AhmedHafez2000/Efficiency-Meter/PCB/README.md

# Pritable PCB
It is a file for DIY project and it represents the bottom side of V2 PCB.
The top side connections are jumper wires.
 
NOTE: Make sure to print the file in actual size scale
