AhmedHafez2000/Efficiency-Meter/PCB/2D-Top-V2.png

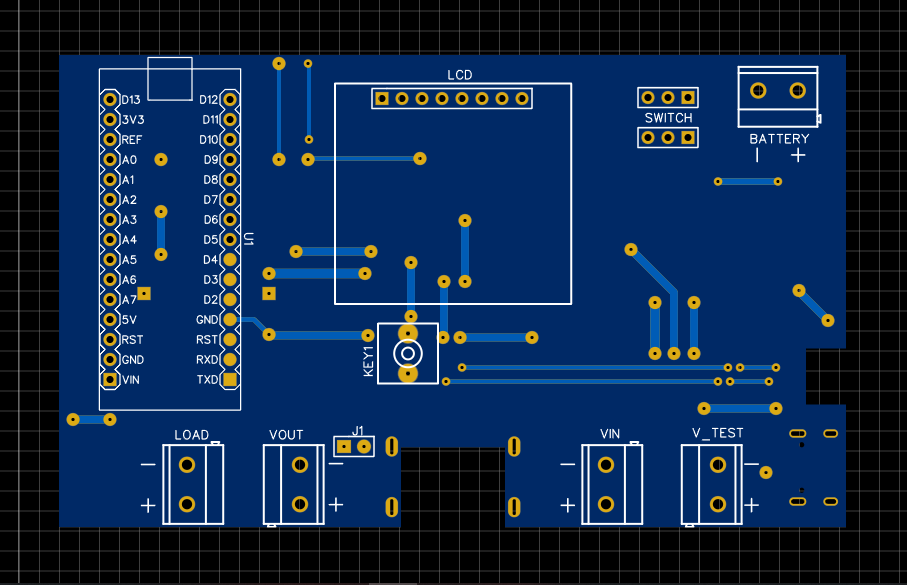
PCB/2D-Top-V2.png
