AhmedHafez2000/Efficiency-Meter/PCB/V3-2D-Top.png

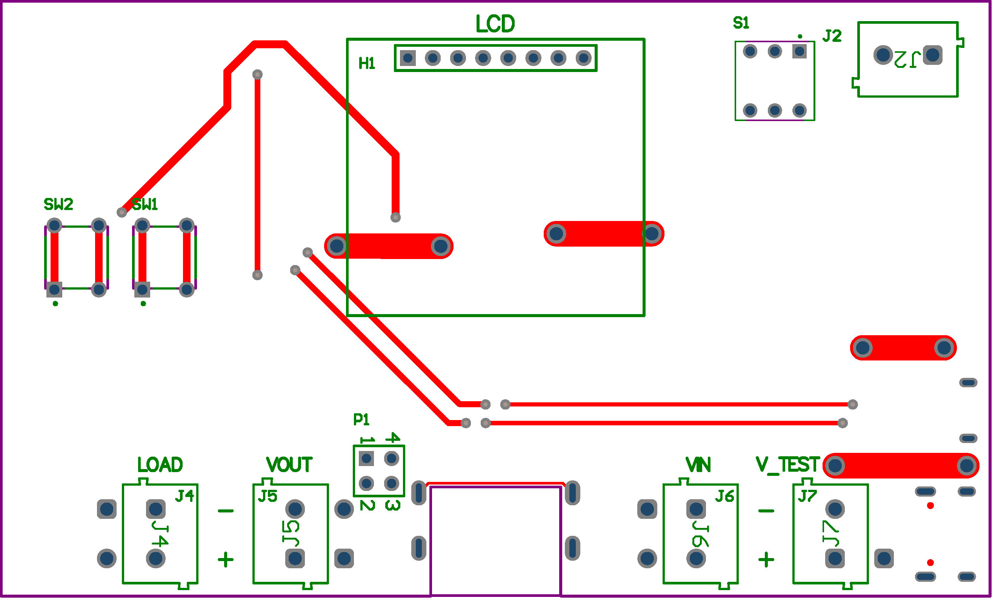
PCB/V3-2D-Top.png
