AhmedHafez2000/Efficiency-Meter/Photos/IMG_1.jpg

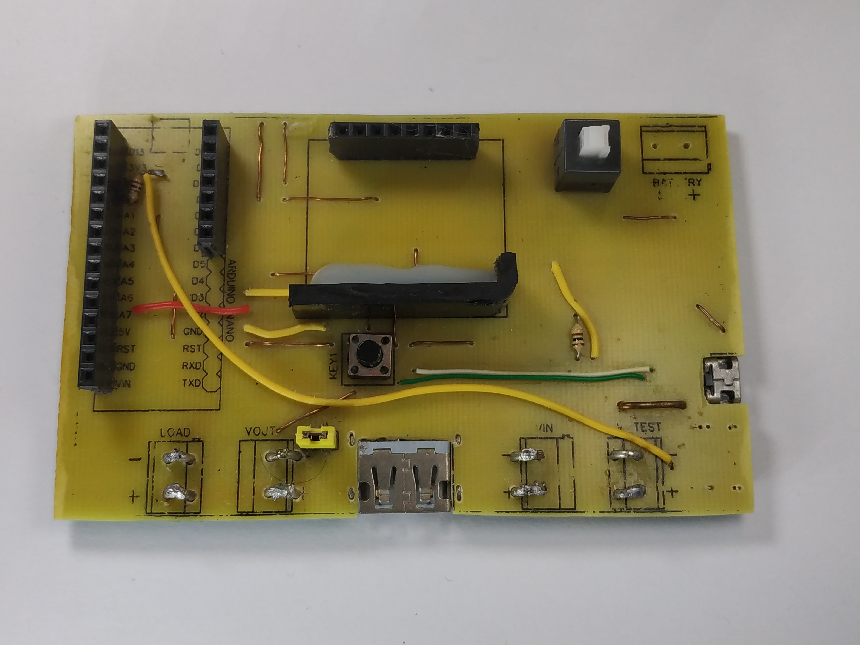
Photos/IMG_1.jpg
