AhmedHafez2000/Efficiency-Meter/Photos/IMG_5.jpg

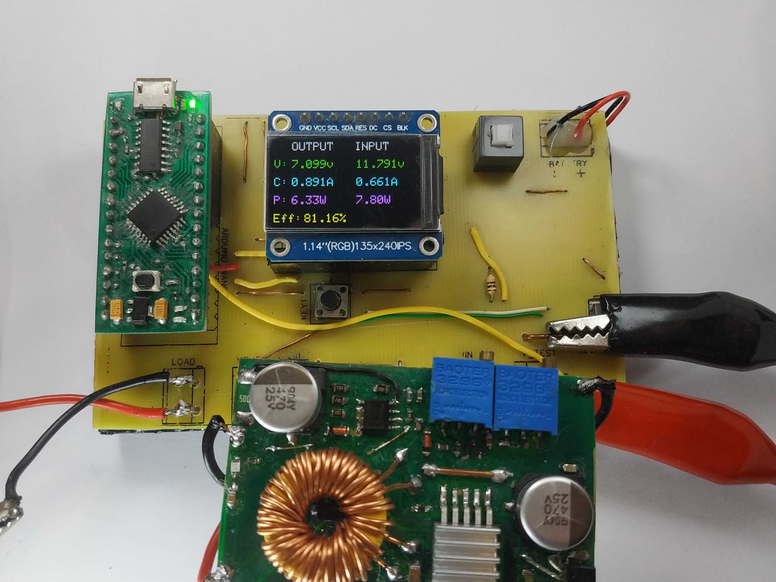
Photos/IMG_5.jpg
