AhmedHafez2000/Efficiency-Meter/Photos/IMG_6.jpg

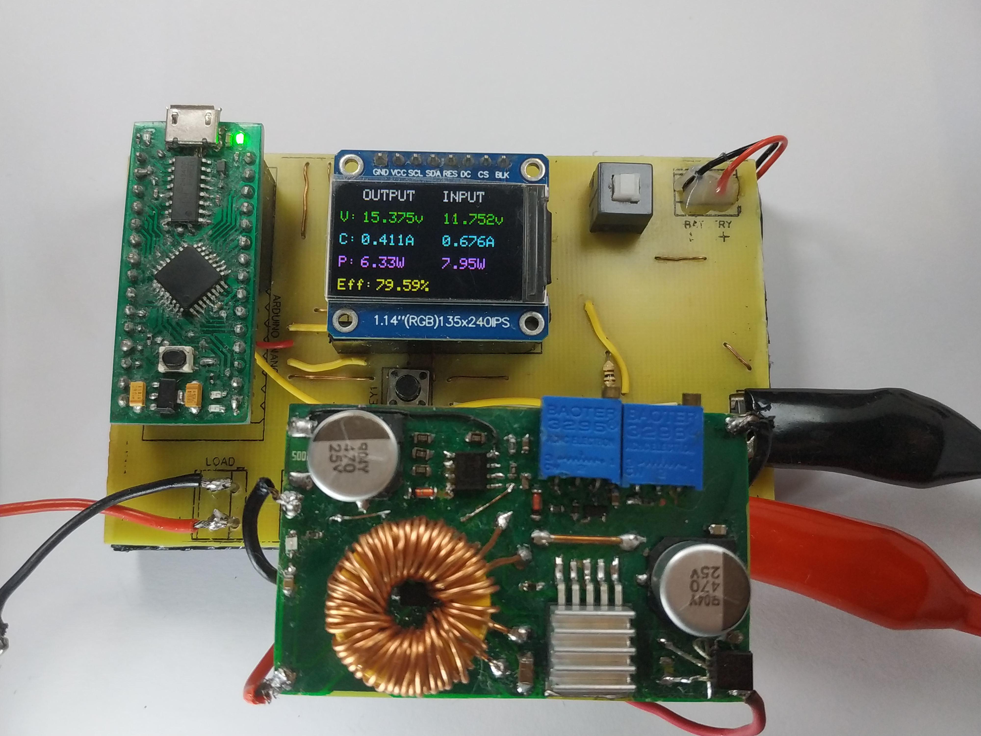
Photos/IMG_6.jpg
