AhmedHafez2000/Efficiency-Meter/Photos/IMG_7.jpg

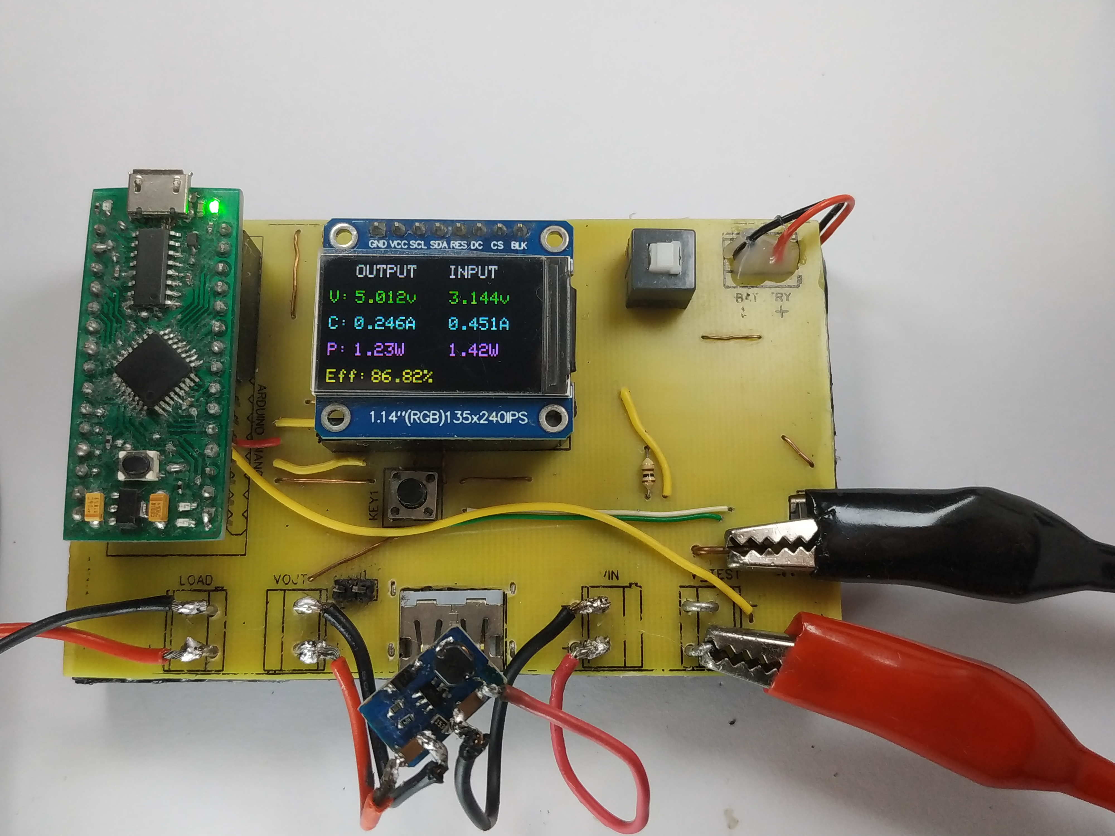
Photos/IMG_7.jpg
