AhmedHafez2000/Efficiency-Meter/Photos/IMG_10.jpg

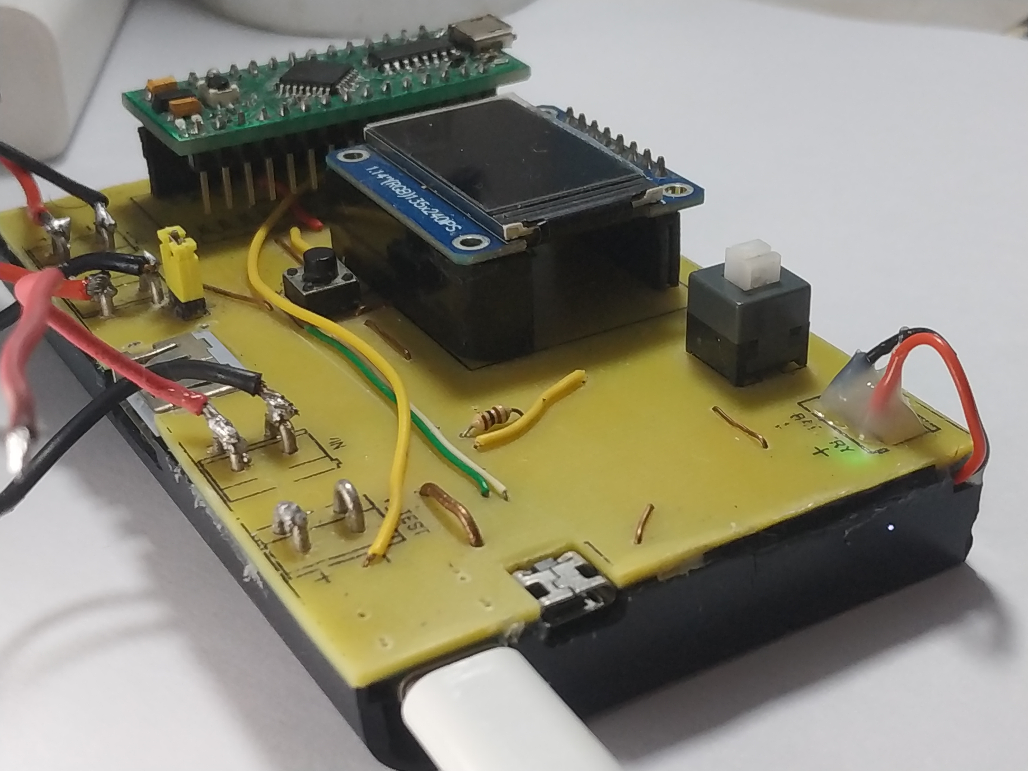
Photos/IMG_10.jpg
