AhmedHafez2000/Efficiency-Meter/Photos/IMG_11.jpg

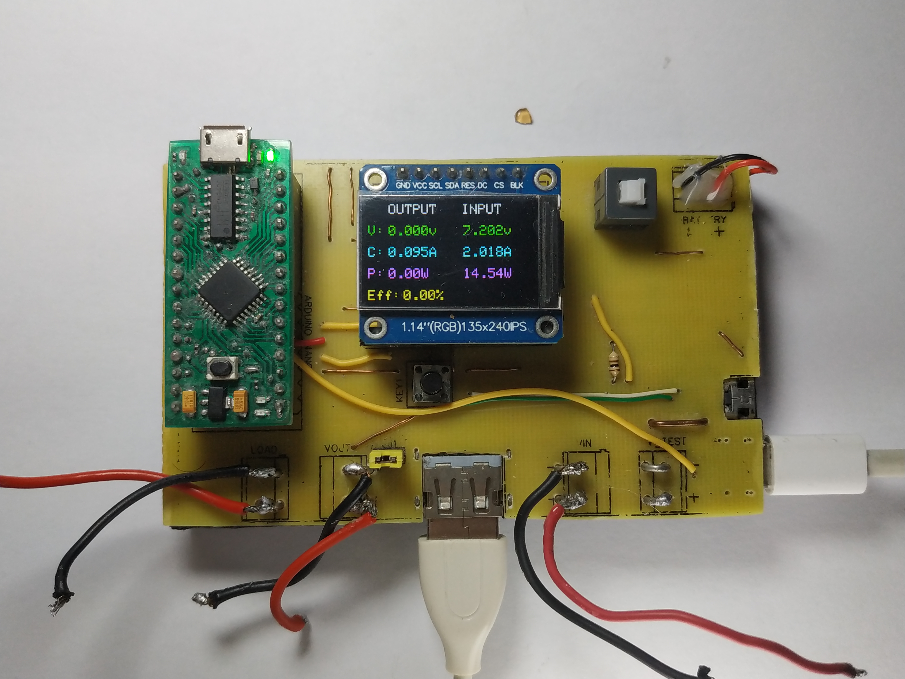
Photos/IMG_11.jpg
