AhmedHafez2000/Efficiency-Meter/PCB/Printable_PCB_Efficiency-Meter-V2.pdf

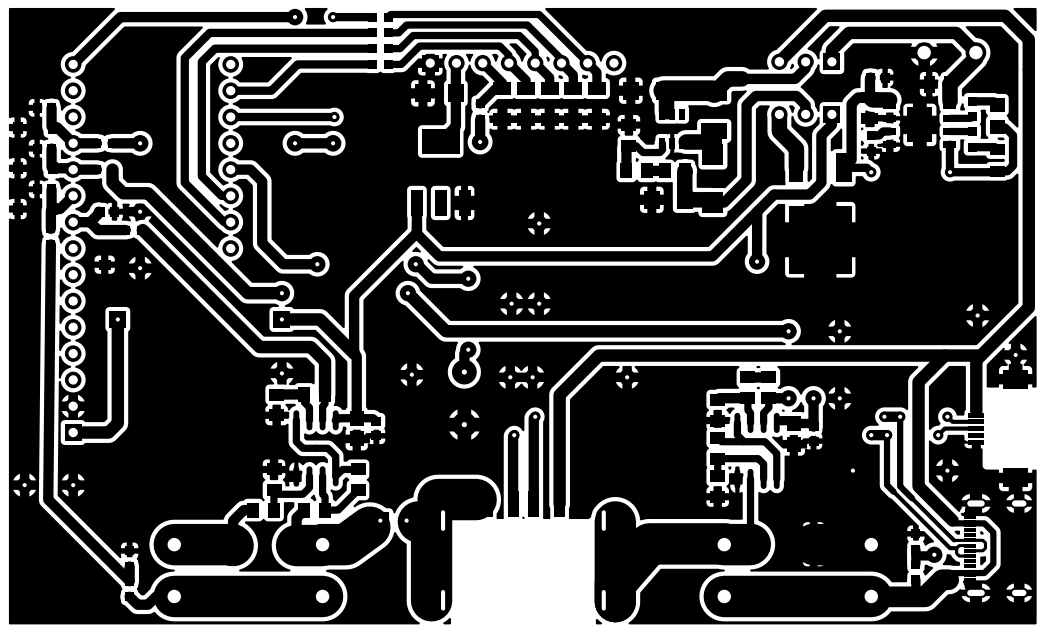
[picture p23: page 1]
