AhmedHafez2000/Efficiency-Meter/Schematic/Schematic_Efficiency-Meter-V3.pdf

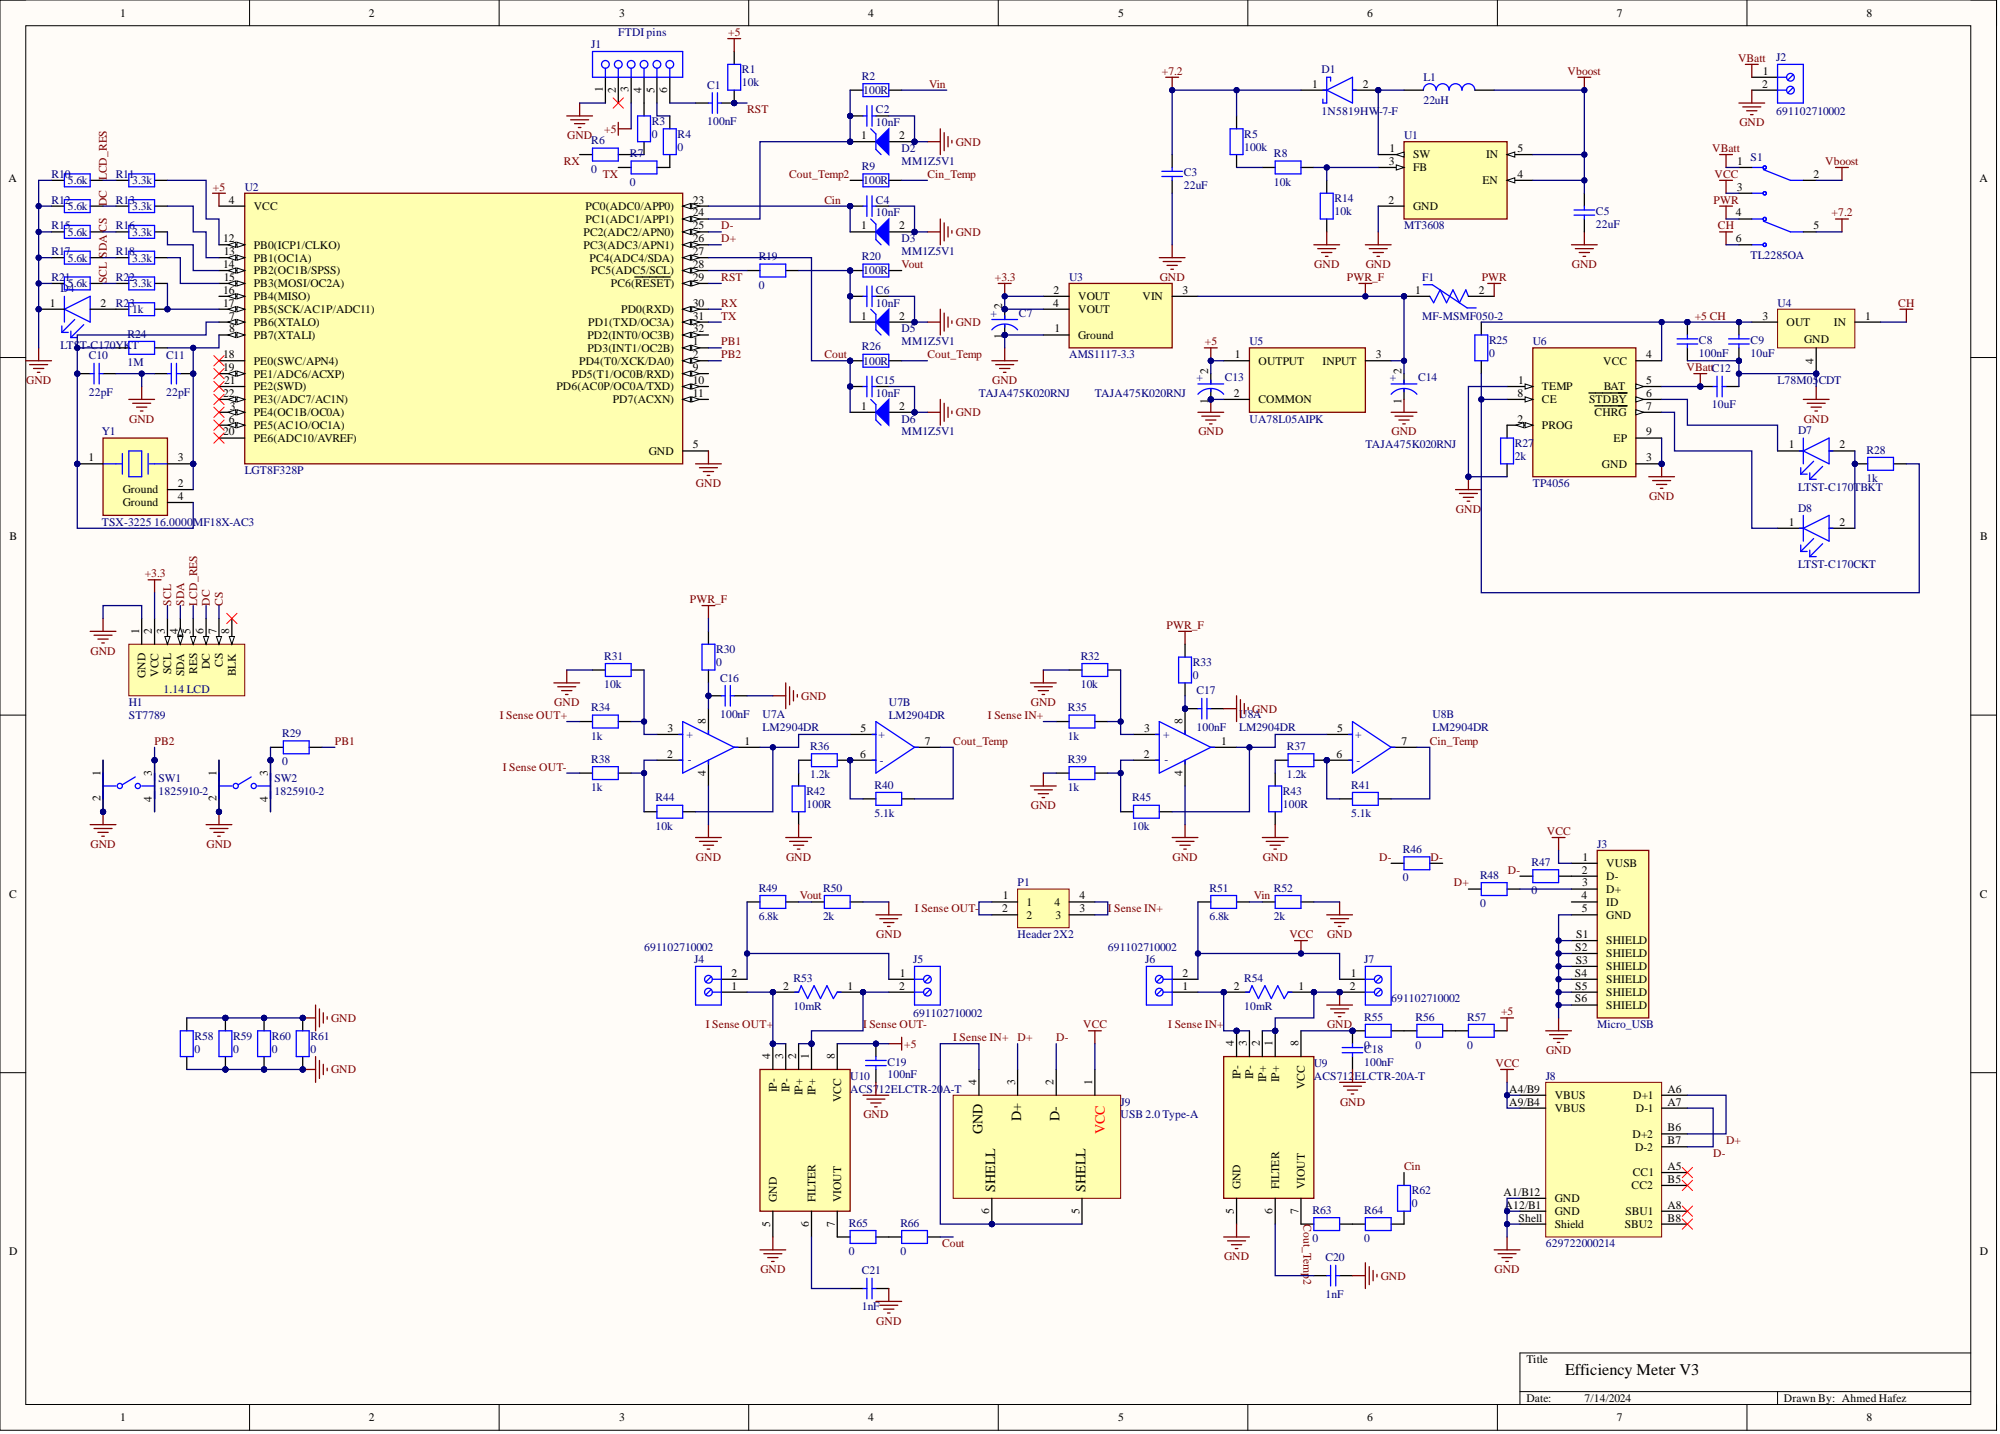
[picture p24: page 1]
