AhmedHafez2000/Efficiency-Meter/PCB/Efficiency_Meter_V3.PDF

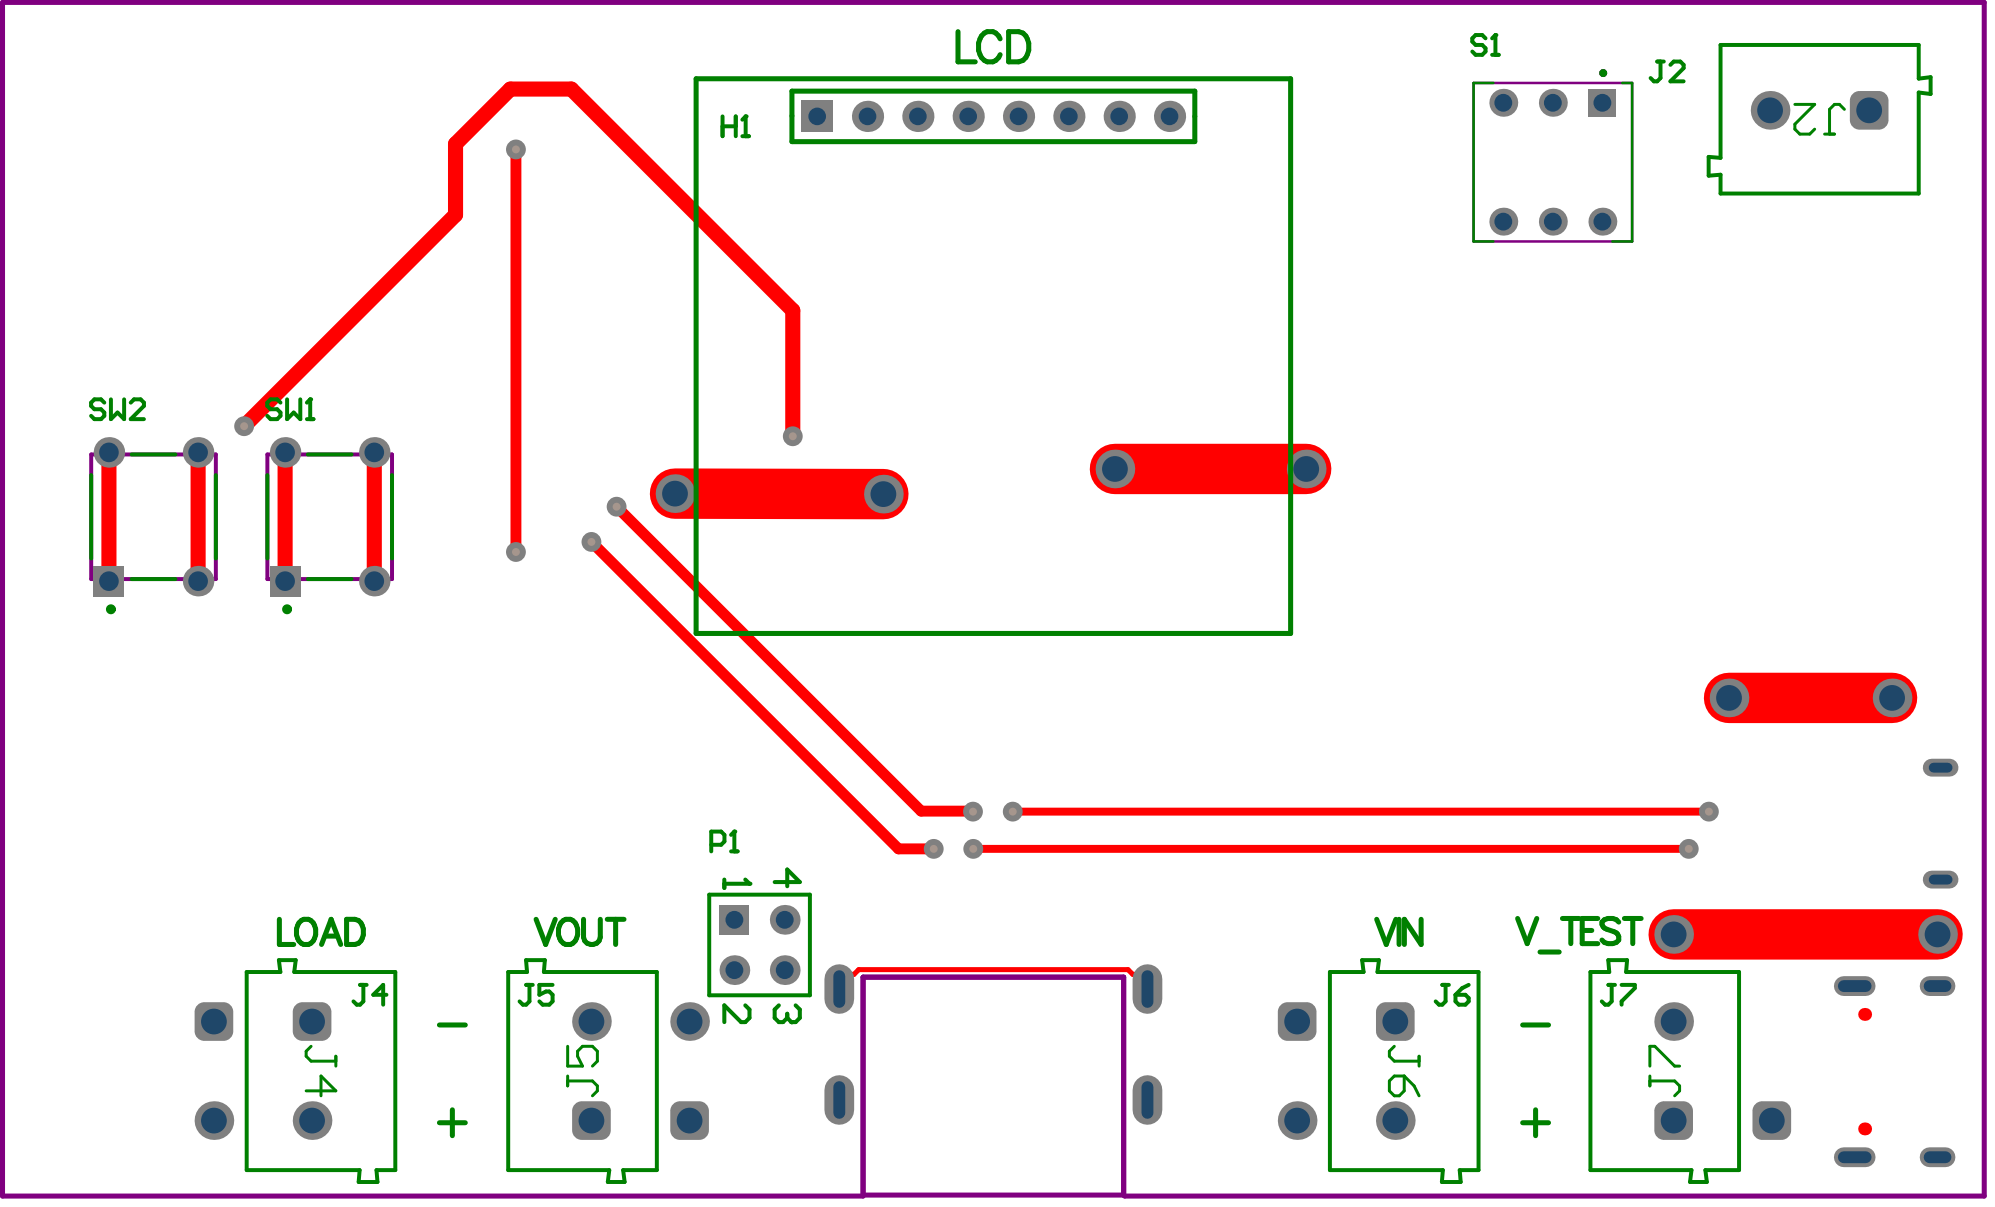
[picture p25: page 1]

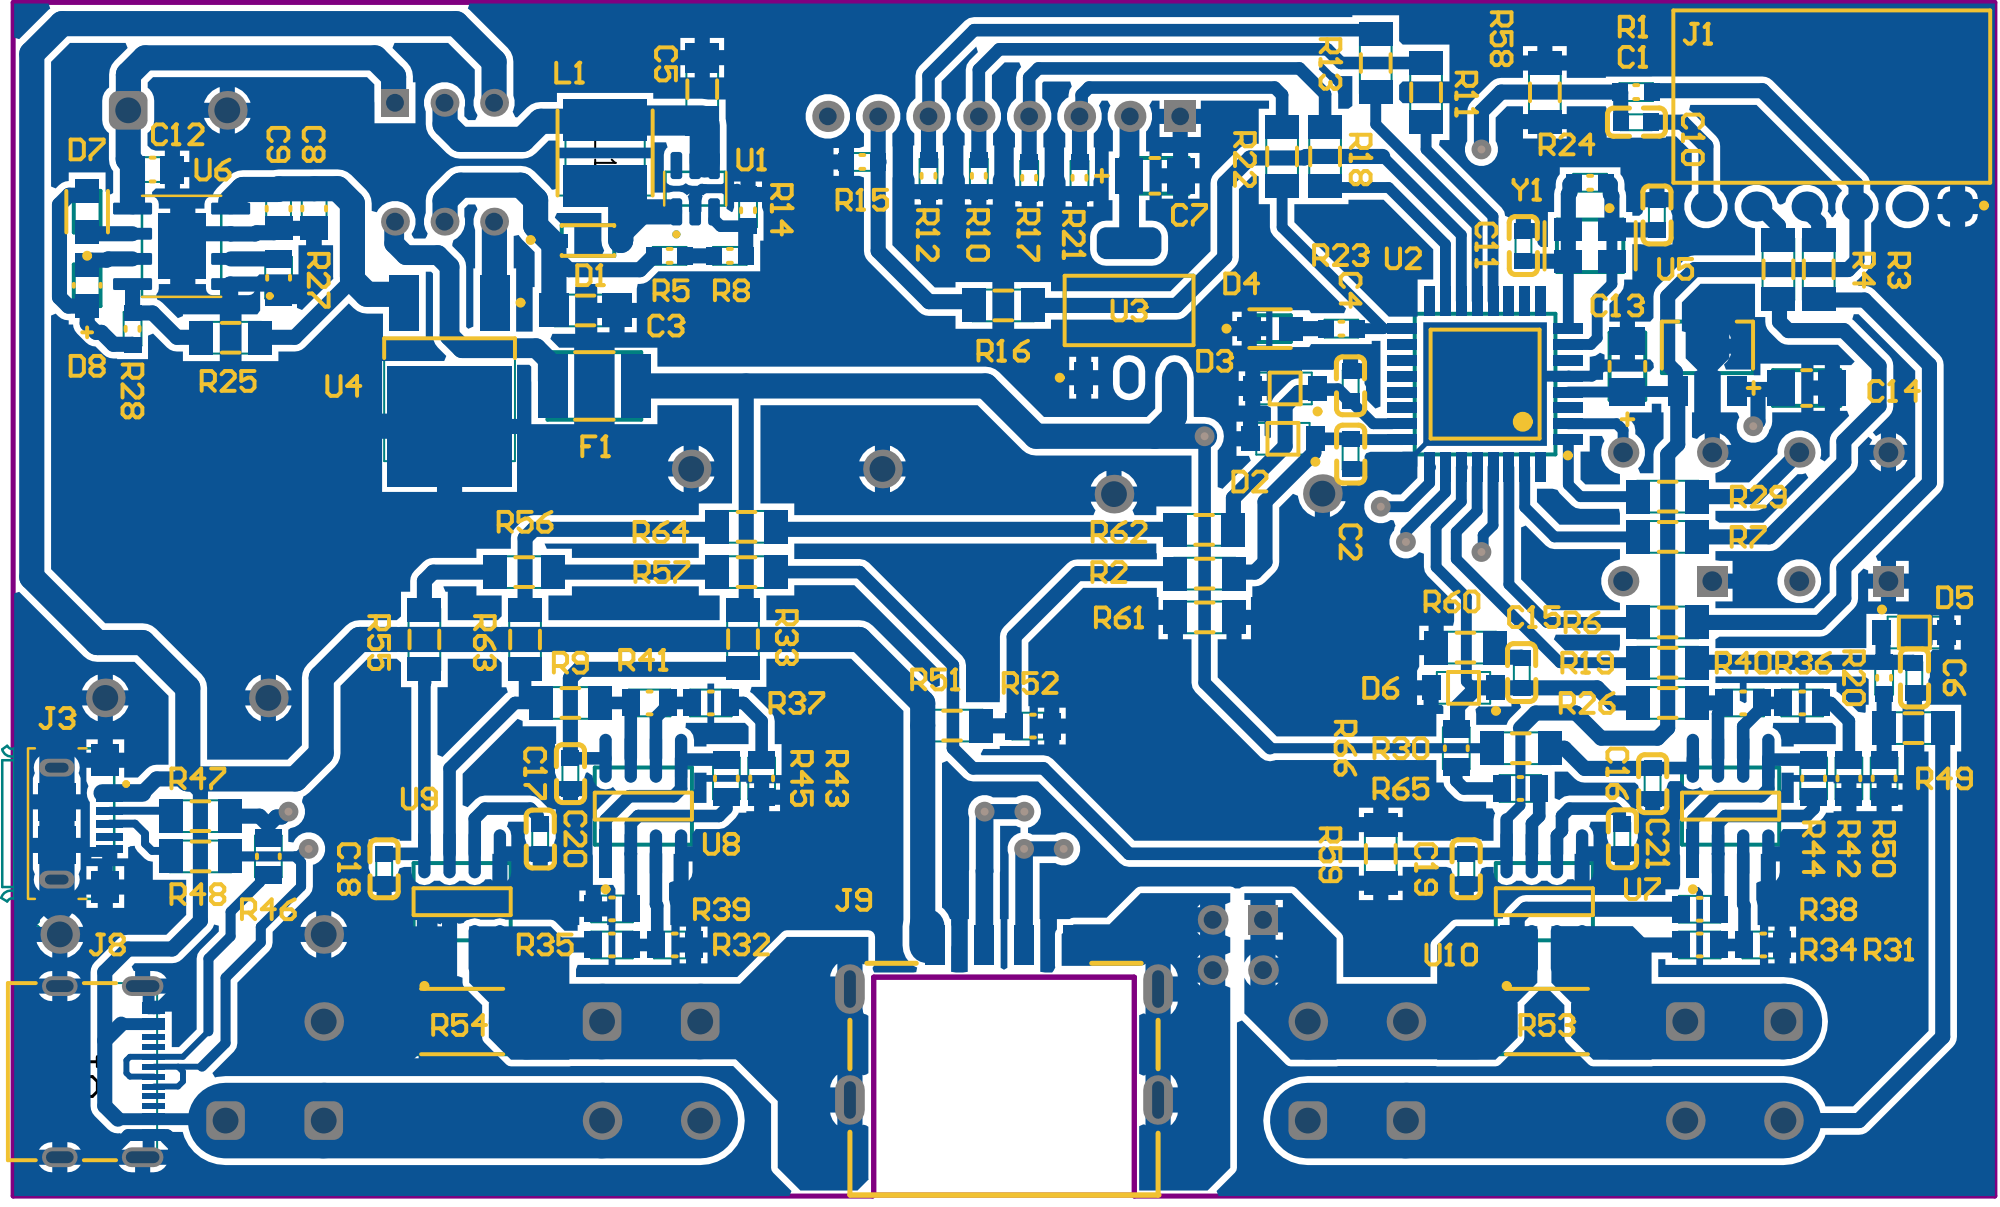
[picture p26: page 2]

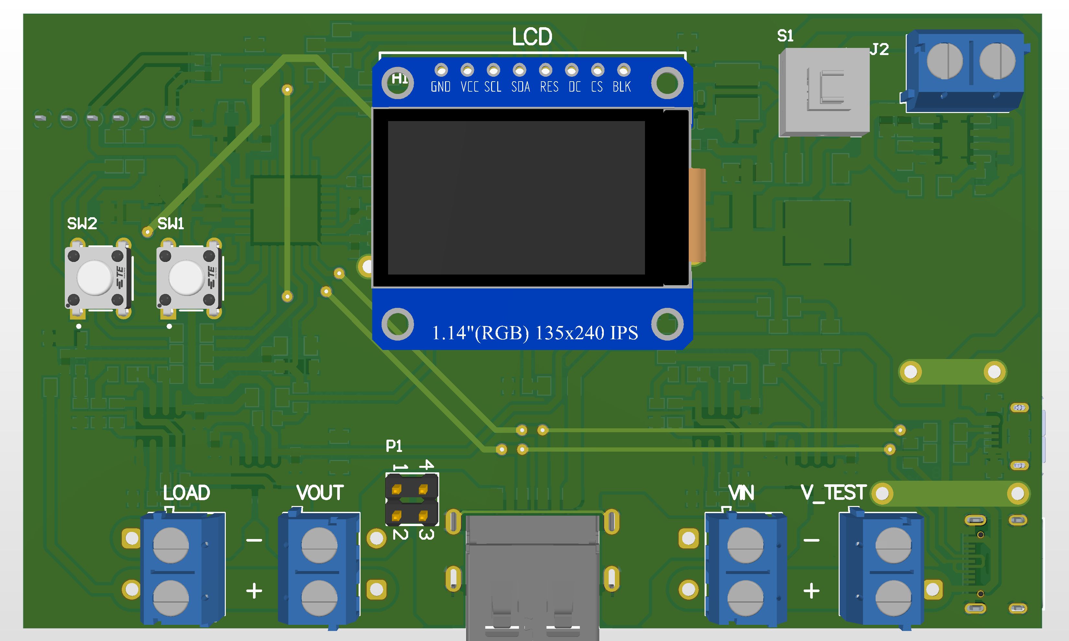
[picture p27: page 3]

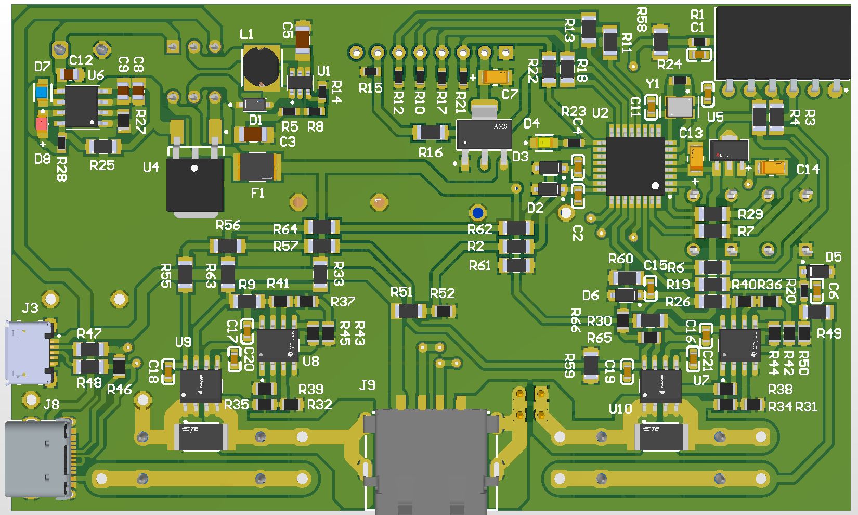
[picture p28: page 4]
