AhmedHafez2000/Efficiency-Meter/Schematic/Schematic_Efficiency-Meter-V2.pdf

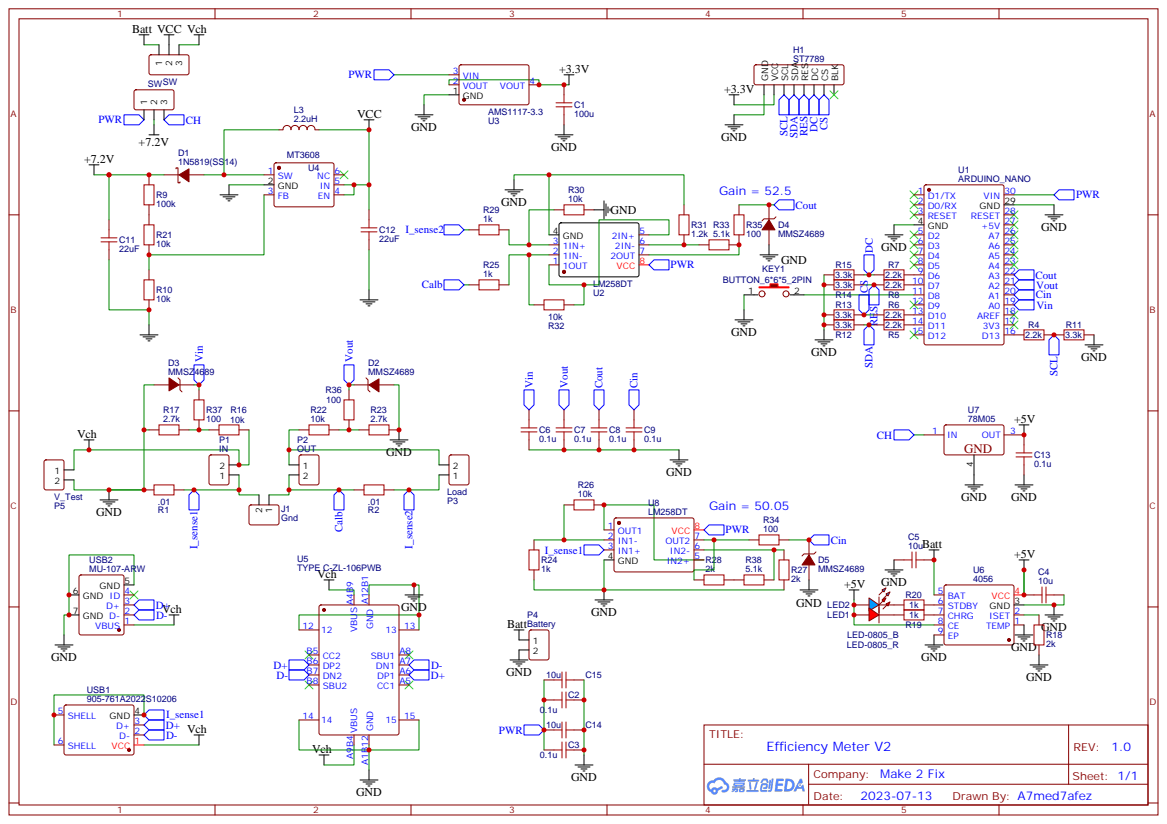
[picture p29: page 1]
